marfikus/thermostat/(commit log)

2022-01-08 Correct work. Config for Arduino
2022-01-09 Add variant with relay protection
2022-01-11 Add led indication of heater state in _relay_protection version. Configured for Arduino
2022-01-11 Rename files, 'thermostat_with_relay_protection' configured for Arduino, ok
2022-01-11 Rename 'thermostat_with_adjust_up_limit', add led indication of heater state, tested, configured for tiny13
2022-01-11 Rename 'thermostat_simple', add led indication of heater state, tested, configured for tiny13
2022-01-11 'simple' and 'with_adjust_up_limit' configured for arduino, all tested on arduino and tiny13
2022-01-19 Renaming, change SENSOR_MAX to 70 deg
2022-01-20 Add schematics
2022-01-21 Add license, readme, change SENSOR_MAX to 100 deg
2022-01-21 Add trigger counter, some corrections..
    [thermostat_simple.ino, thermostat_with_adjust_up_limit.ino, thermostat_without_sparking_on_relay.ino]
